clfreeman7/Fabrication/Basic_Mechatronics.jpg

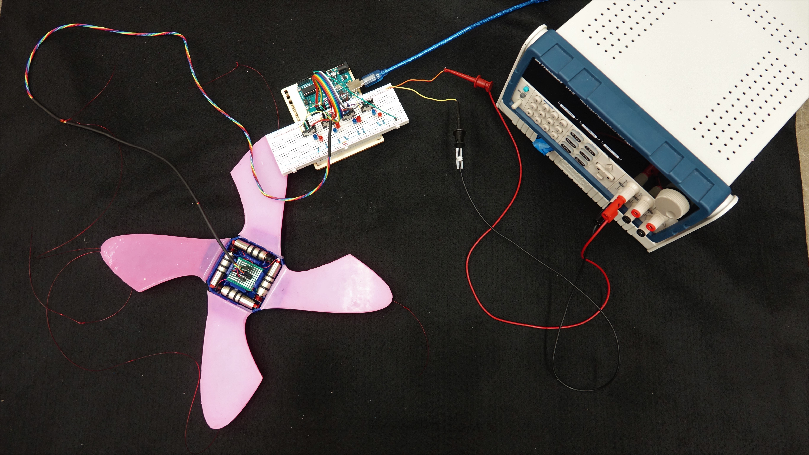
Basic_Mechatronics.jpg
